najjarapu/PCB_Waveguides_for_Houck_Lab_of_Quantum_Computing/Cadence Allegro Files/Board Imports/netlist_8_SSMA_8_filter_12_screwhole.txt

(NETLIST)
(FOR DRAWING: /n/homeserver2/user2a/ajjarapu/quibit_qed_III_info/qubit_qed_III.brd)

(GENERATED BY: ALLEGRO 16.6 S006 (v16-6-112Z))

(Wed Jul  8 16:53:02 2015)

$PACKAGES
HOLE070P ! HOLE070P ; MTG1 MTG2 MTG3 MTG4 MTG5 MTG6 MTG7 MTG8 

SSMA_BB ! SSMA_BB ; J1 J2 J3 J4 J5 J6 J7 J8 J9 J10 J11 J12
 
FILTER ! FILTER ; R1 R2 R3 R4 R5 R6 R7 R8 R9 R10 R11 R12 
 $NETS
GND ; J1.2 J1.3 J2.2 J2.3 J3.2 J3.3 J4.2 J4.3 J5.2 J5.3 J6.2 J6.3 J7.2 J7.3,
J8.2 J8.3 J9.2 J9.3 J10.2 J10.3 J11.2 J11.3 J12.2 J12.3 MTG1.1 MTG2.1 MTG3.1,
MTG4.1 MTG5.1 MTG6.1 MTG7.1 MTG8.1
MICROWAVE ; J1.1 J2.1 J3.1 J4.1 J5.1 J6.1 J7.1 J8.1 J9.1 J10.1 J11.1 J12.1,
R1.1 R2.1 R3.1 R4.1 R5.1 R6.1 R7.1 R8.1 R9.1 R10.1 R11.1 R12.1 
$PINS
$A_PROPERTIES
DYN_THERMAL_CON_TYPE 'FULL_CONTACT'; MTG5.1 MTG6.1 MTG4.1 MTG1.1 MTG3.1,
MTG2.1 MTG7.1 MTG8.1
DYN_CLEARANCE_TYPE 'ANTI_THERMAL'; J3.1 J1.1 J5.1 J7.1 J9.1 J8.1 J11.1,
J12.1 J10.1 J4.1 J2.1 J6.1
$END
