najjarapu/PCB_Waveguides_for_Houck_Lab_of_Quantum_Computing/Cadence Allegro Files/Art/98_board_art/NOTES/More Notes.txt

- DRILLING: ALL HOLES TO BE LOCATED BY X & Y COORDINATES 
   FROM NC DRILL DATA SUPPLIED. SEE DRILL TABLE FOR HOLE 
   SIZES AND QUANTITY DRILLED HOLE TRUE POSITION DIFFERENCE 
   FROM CAD DATA IS NOT TO EXCESS 0.005"
 - MINIMUM ANULAR RING OF 1 MIL. UNLESS OTHERWISE SPECIFIED
 - COPPER PLATING HOLE WALL TO BE .001" MINIMUM 
 - FINISH COPPER SURFACE NOT TO BE PLATED
 - CONDUCTOR: WIDTHS AND SPACING: TRACE WIDTH CAN BE 
   MODIFIED TO ACHEIVE 50 OHM CHARACTERISITC IMPEDANCE 
 - CENTER CUTOUT SQUARE CENTERED @ 0,0. CUTOUT 1-3 SHOULD
   EXPOSE LAYER 03_SIG COPPER TRACE
