najjarapu/PCB_Waveguides_for_Houck_Lab_of_Quantum_Computing/Cadence Allegro Files/Art/98_board_art/NOTES/More Notes - Copy.txt

 - CENTER CUTOUT SQUARE CENTERED @ 0,0. CUTOUT 1-3 SHOULD
   EXPOSE LAYER 03_SIG COPPER TRACE
