najjarapu/PCB_Waveguides_for_Houck_Lab_of_Quantum_Computing/Cadence Allegro Files/allegro_project/worklib/test070615/physical/139cad.dxf

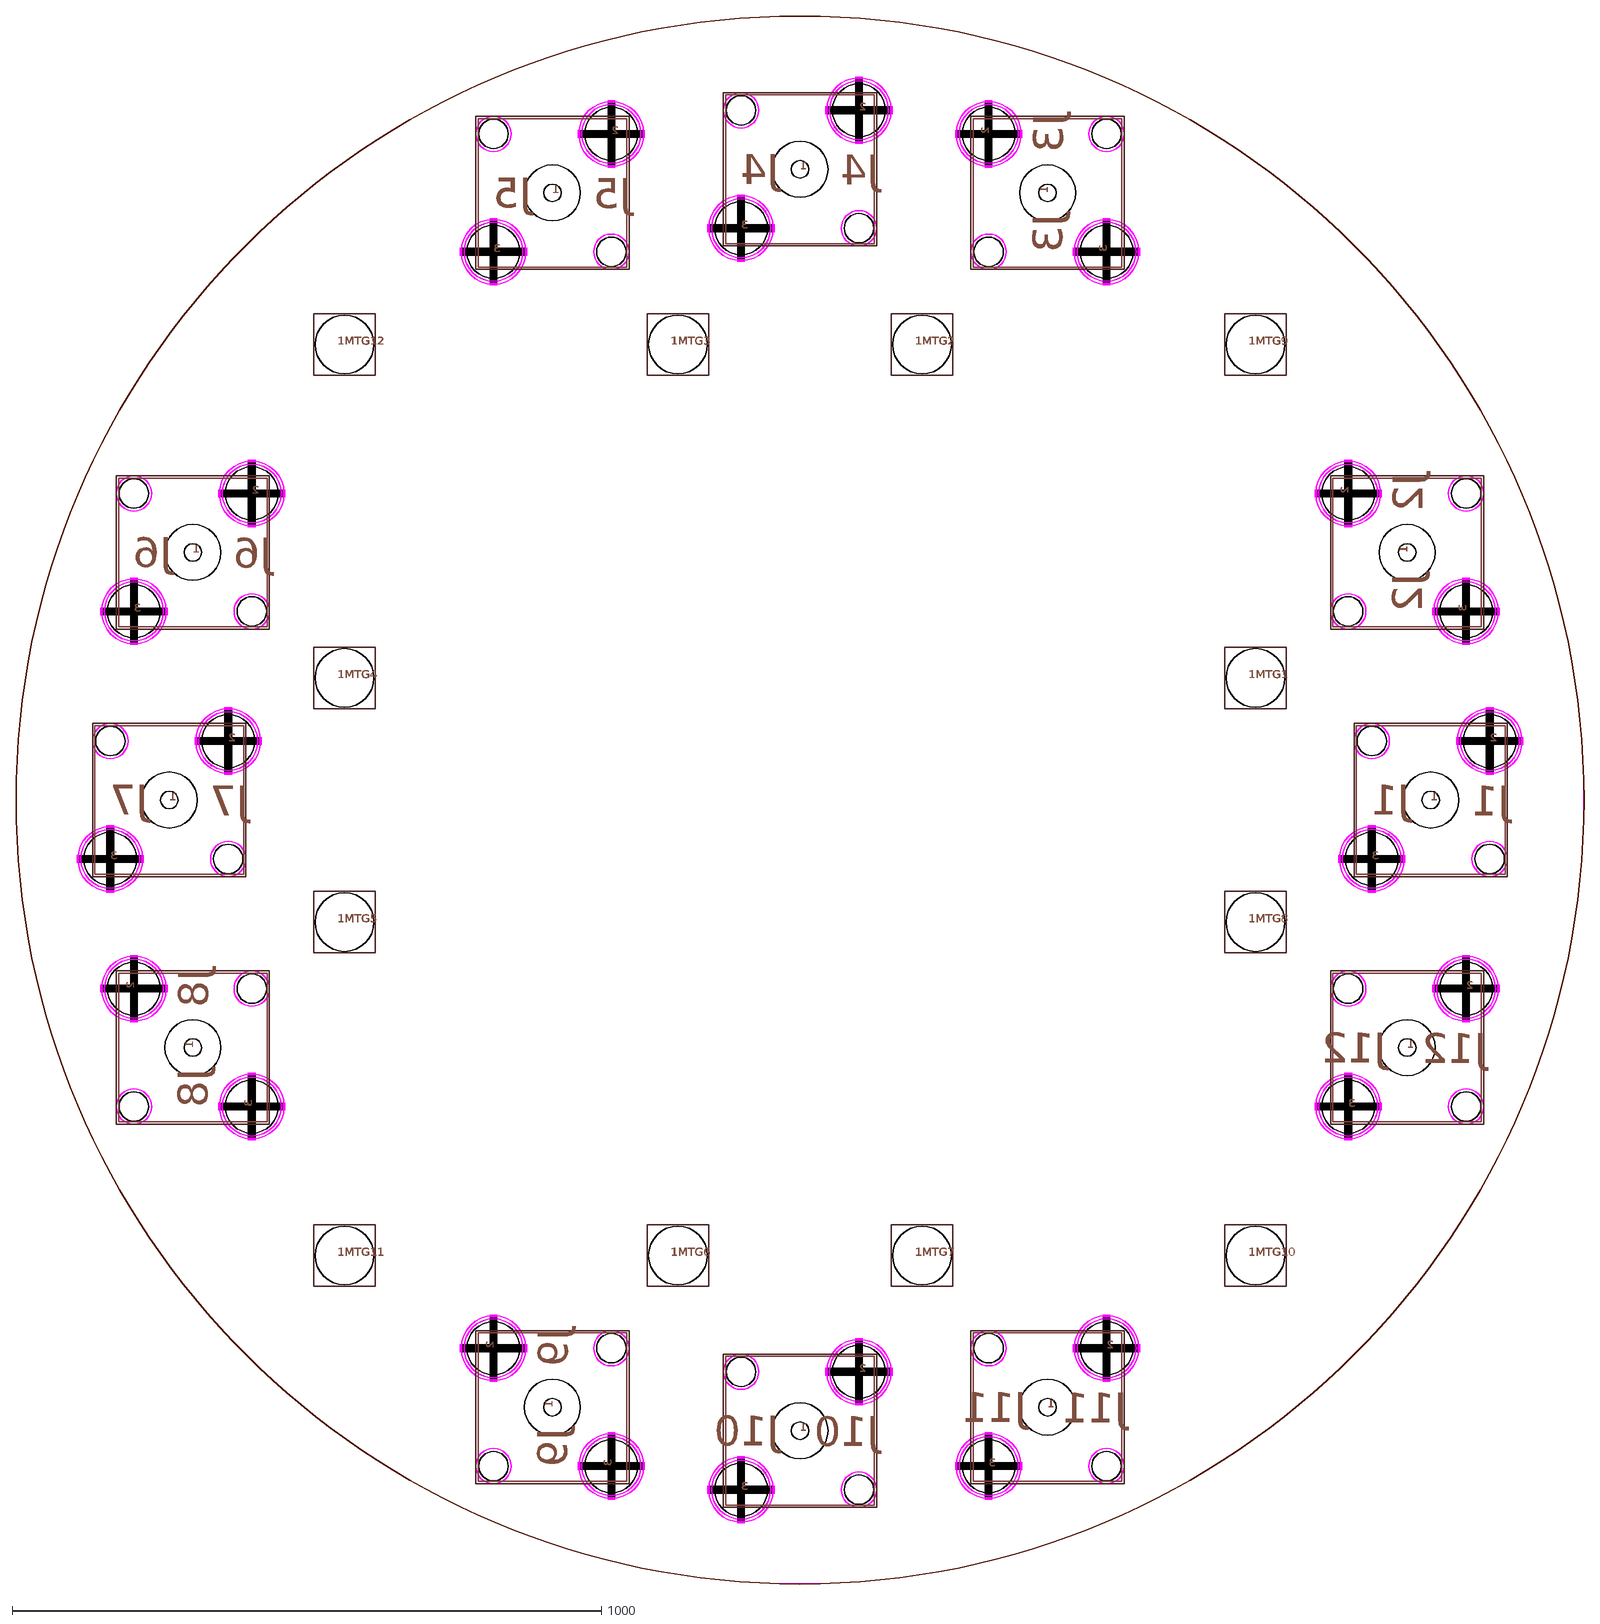
[picture p1: CAD file, 2015-08-13]
Cadence Allegro Files/allegro_project/worklib/test070615/physical/139cad.dxf
1
MTG12
MTG11
MTG10
MTG9
MTG8
MTG7
MTG6
MTG5
MTG4
MTG3
MTG2
MTG1
2
3
J12
J11
J10
J9
J8
J7
J6
J5
J4
J3
J2
J1
