najjarapu/PCB_Waveguides_for_Houck_Lab_of_Quantum_Computing/Cadence Allegro Files/Copper Cad Files/PCB_Bottom_7X7/PCB_bottom_7X7.dxf

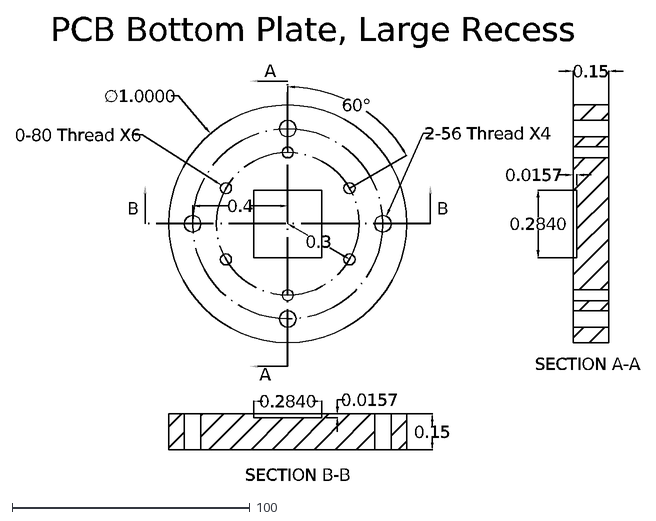
[picture p2: CAD file, 2015-08-13]
Cadence Allegro Files/Copper Cad Files/PCB_Bottom_7X7/PCB_bottom_7X7.dxf
∅1.0000
0-80 Thread X6
2-56 Thread X4
A
B
0.15
SECTION A-A
SECTION B-B
60°
0.3
0.4
0.0157
0.2840
PCB Bottom Plate, Large Recess
