najjarapu/PCB_Waveguides_for_Houck_Lab_of_Quantum_Computing/Cadence Allegro Files/Copper Cad Files/PCB_Top_7X7/PCB_top.dxf

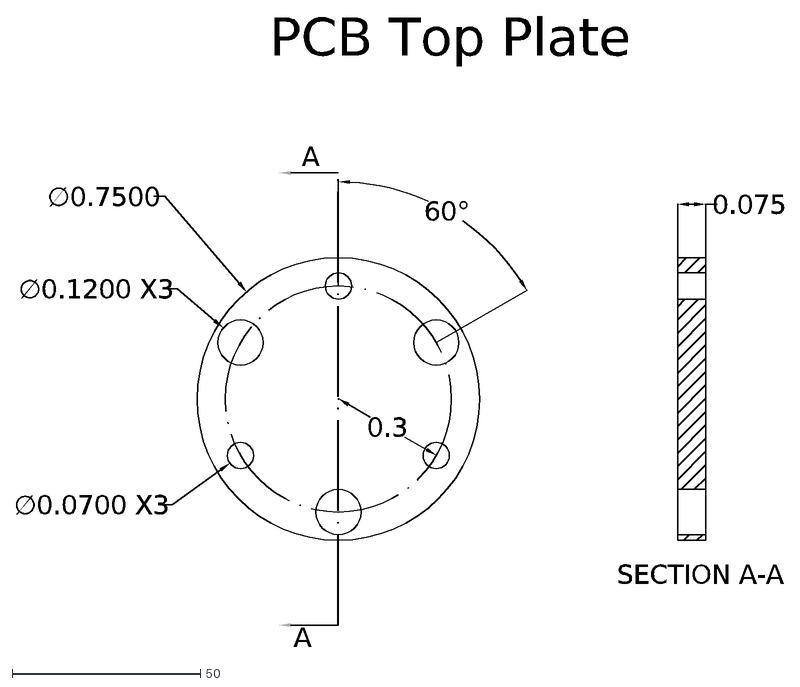
[picture p3: CAD file, 2015-08-13]
Cadence Allegro Files/Copper Cad Files/PCB_Top_7X7/PCB_top.dxf
∅0.7500
A
0.075
SECTION A-A
60°
∅0.1200 X3
∅0.0700 X3
0.3
PCB Top Plate
