najjarapu/PCB_Waveguides_for_Houck_Lab_of_Quantum_Computing/Cadence Allegro Files/Copper Cad Files/Rod/rod_90.dxf

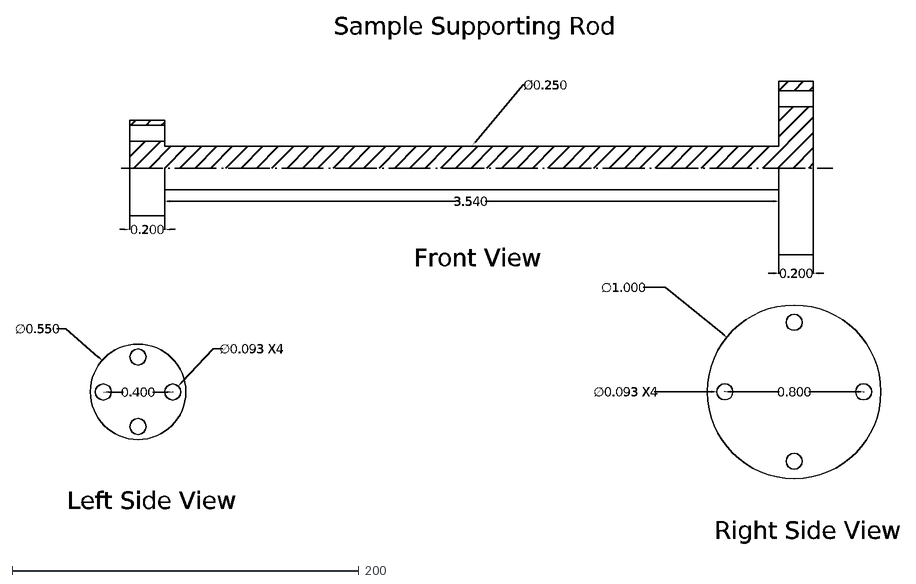
[picture p4: CAD file, 2015-08-13]
Cadence Allegro Files/Copper Cad Files/Rod/rod_90.dxf
Sample Supporting Rod
Ø0.250
Front View
∅0.550
Left Side View
0.200
Right Side View
∅1.000
∅0.093 X4
0.400
0.800
3.540
