najjarapu/PCB_Waveguides_for_Houck_Lab_of_Quantum_Computing/(list of files, cad)

Other CAD files:
Cadence Allegro Files/Copper Cad Files/FilterCopperBottom/FIlterCopperBottom.dwg
Cadence Allegro Files/Copper Cad Files/FilterCopperTop/FilterCopperTop.dwg
Cadence Allegro Files/Copper Cad Files/PCB_BOTTOM_139/PCB_BOTTOM_RECT.dwg
Cadence Allegro Files/Copper Cad Files/PCB_BOttom_98/PCB_BOTTOM_98.dwg
Cadence Allegro Files/Copper Cad Files/PCB_TOP_98_139/PCB_TOP_RECT.dwg
Cadence Allegro Files/Boards/OlderBoards/Spiral_DuoDeca.dwg
Cadence Allegro Files/Copper Cad Files/PCB_Bottom_7X7/PCB_bottom_7X7.dwg
Cadence Allegro Files/Copper Cad Files/PCB_Top_7X7/PCB_top.dwg
Cadence Allegro Files/Copper Cad Files/Rod/rod_90.dwg
Cadence Allegro Files/allegro_project/worklib/test070615/physical/7_7_slot_sym.psm
Cadence Allegro Files/allegro_project/worklib/test070615/physical/filter.psm
Cadence Allegro Files/allegro_project/worklib/test070615/physical/hole070p.psm
Cadence Allegro Files/allegro_project/worklib/test070615/physical/ssma_bb.psm
Cadence Allegro Files/allegro_project/worklib/test070615/physical/via10sym.psm
