najjarapu/PCB_Waveguides_for_Houck_Lab_of_Quantum_Computing/Cadence Allegro Files/Art/98_board_art/NOTES/MANUFACTURE_NOTES.txt

NOTES: UNLESS OTHERWISE SPECIFIED
 - CLASS 2
 - MATERIAL: FR408 RECOMMENDED
 - COPPER WEGITH: SEE XSECTION
 - BOARD FINISH THICKNESS; 0.057 INCHES +/- <.010 OR 10%
 - SOLDERMASK: NOT REQUIRED
 - ALL INSIDE CORNERS AND SLOTS SHALL HAVE .062 INCHES 
   +/- 0.005" OR LESS RADIUS
 - LEGEND/SILKSCREEN: NOT REQUIRED
