najjarapu/PCB_Waveguides_for_Houck_Lab_of_Quantum_Computing/Cadence Allegro Files/allegro_project/worklib/test070615/physical/netlist_only adds_MTG_7_8.txt

(NETLIST)
(FOR DRAWING: /n/homeserver2/user2a/ajjarapu/quibit_qed_III_info/qubit_qed_III.brd)

(GENERATED BY: ALLEGRO 16.6 S006 (v16-6-112Z))

(Wed Jul  8 16:53:02 2015)

$PACKAGES
HOLE070P ! HOLE070P ; MTG7 MTG8

 $NETS
GND ; MTG7.1 MTG8.1 
$PINS
$A_PROPERTIES
DYN_THERMAL_CON_TYPE 'FULL_CONTACT'; MTG7.1 MTG8.1
 $END
