najjarapu/PCB_Waveguides_for_Houck_Lab_of_Quantum_Computing/Cadence Allegro Files/allegro_project/worklib/test070615/physical/Art/FILTERBOARD_PARTIAL_ART/FILTERBOARDPARTIAL.pdf

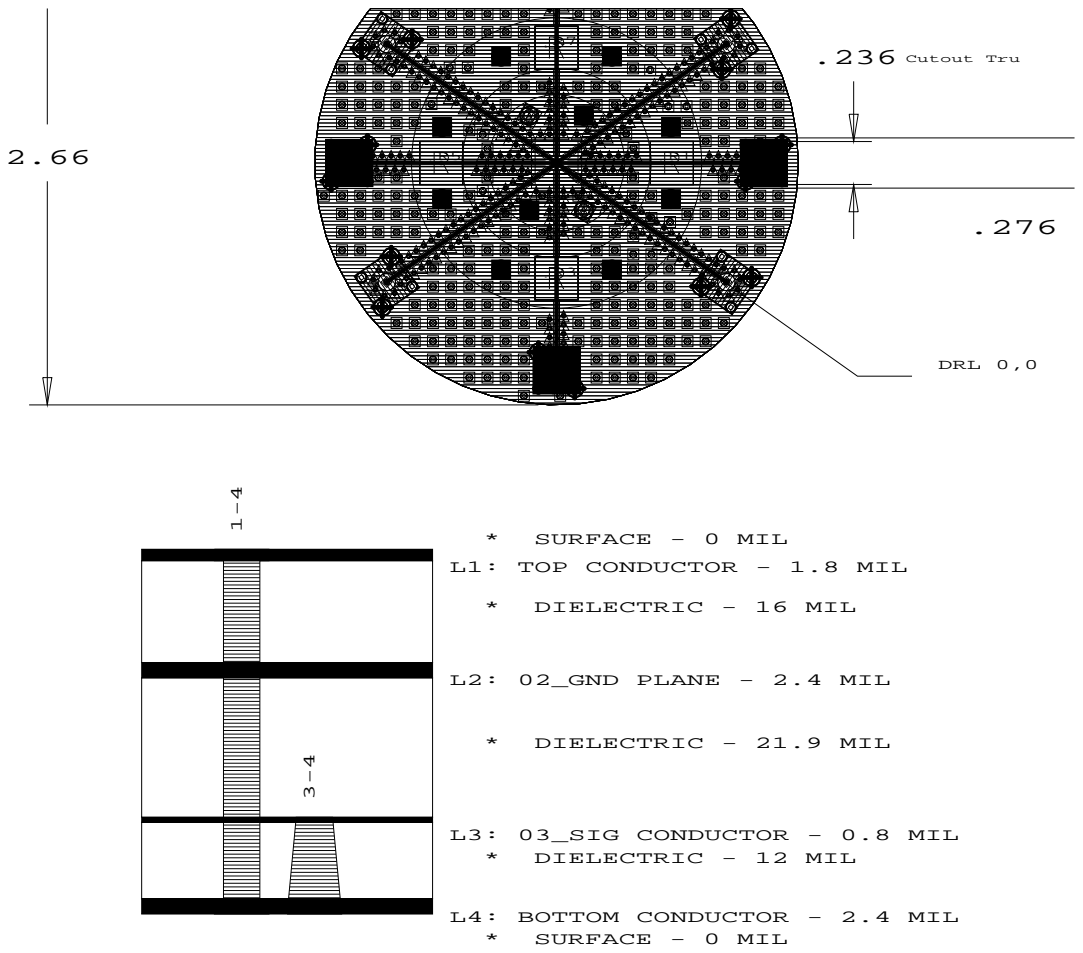
[picture p5: page 1]

1 MTG7 | 1 MTG2

1 MTG6 | R3 | 1 MTG3

# .276 Cutout 1-3

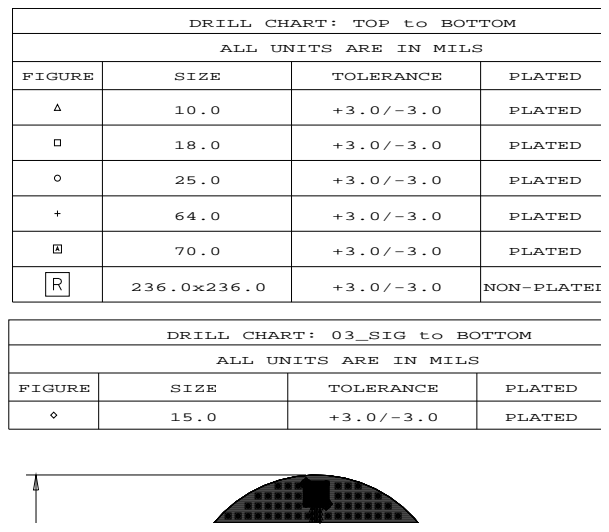
[picture p6: page 3]

DRILL CHART: TOP to BOTTOM
ALL UNITS ARE IN MILS

FIGURE | SIZE | TOLERANCE | PLATED

10.0 | +3.0/-3.0 | PLATED

18.0 | +3.0/-3.0 | PLATED

25.0 | +3.0/-3.0 | PLATED

64.0 | +3.0/-3.0 | PLATED

70.0 | +3.0/-3.0 | PLATED

DRILL CHART: 03_SIG to BOTTOM

15.0 | +3.0/-3.0 | PLATED

NOTES: UNLESS OTHERWISE SPECIFIED
- CLASS 2
- MATERIAL: FR408 RECOMMENDED
- COPPER WEGITH: SEE XSECTION
- BOARD FINISH THICKNESS; 0.057 INCHES +/- <.010 OR 10%
- SOLDERMASK: NOT REQUIRED
- ALL INSIDE CORNERS AND SLOTS SHALL HAVE .062 INCHES +/- 0.005" OR LESS RADIUS
- LEGEND/SILKSCREEN: NOT REQUIRED
- DRILLING: ALL HOLES TO BE LOCATED BY X & Y COORDINATES FROM NC DRILL DATA SUPPLIED. SEE DRILL TABLE FOR HOLE SIZES AND QUANTITY DRILLED HOLE TRUE POSITION DIFFERENCE FROM CAD DATA IS NOT TO EXCESS 0.005"
- MINIMUM ANULAR RING OF 1 MIL. UNLESS OTHERWISE SPECIFIED
- COPPER PLATING HOLE WALL TO BE .001" MINIMUM
- FINISH COPPER SURFACE NOT TO BE PLATED
- CONDUCTOR: WIDTHS AND SPACING: TRACE WIDTH CAN BE MODIFIED TO ACHEIVE 50 OHM CHARACTERISITC IMPEDANCE
- ON THE 8 CAVITIES (R), PLEASE CREATE A 7 MIL X 7 MIL ABOVE THEM IN THE SAME ORIENTATION THROUGH LAYERS 1 AND
2 TO EXPOSE LAYER 3 (SAME DIMENSIONS AS CENTER CAVITY)
4 | 7MM x 7MM

# QTY

286

299

16

16

12

# NON-PLATED 4

8

# QTY
