najjarapu/PCB_Waveguides_for_Houck_Lab_of_Quantum_Computing/Cadence Allegro Files/Copper Cad Files/PCB_Bottom_7X7/PCB_bottom_7X7.pdf

# PCB Bottom Plate, Large Recess

### PRODUCED BY AN AUTODESK EDUCATIONAL PRODUCT

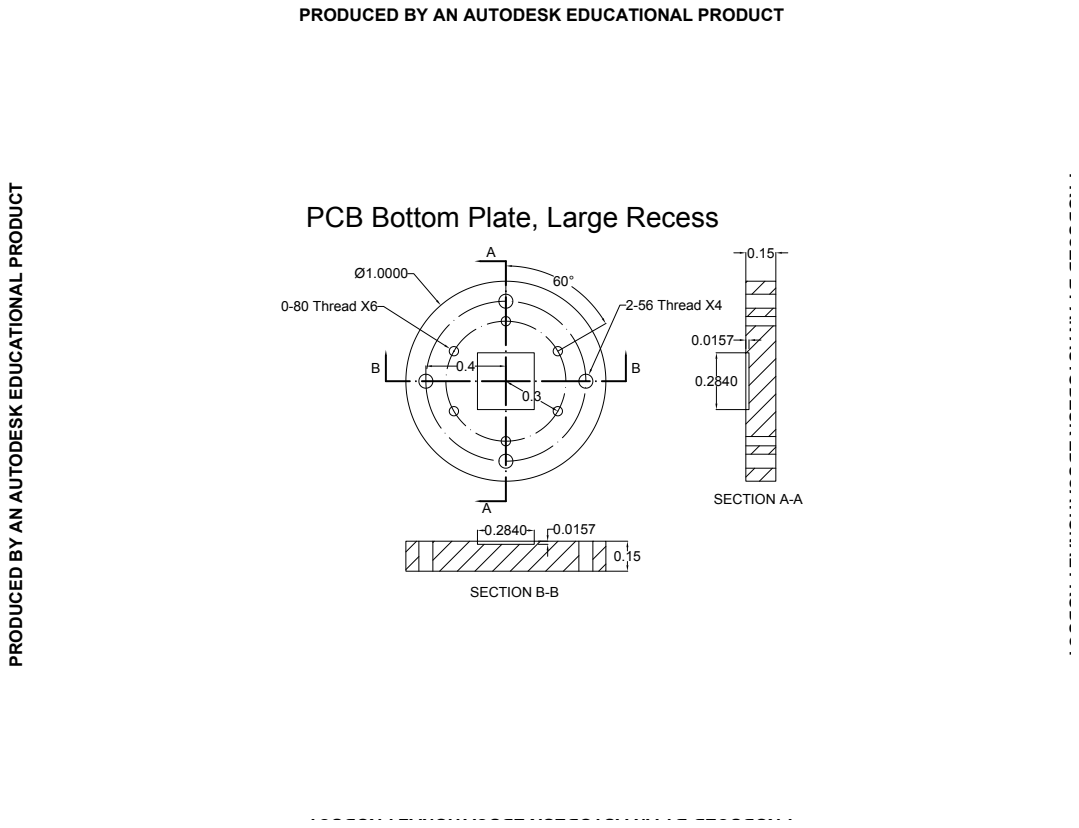
[picture p7: page 1]
0-80 Thread X6; 2-56 Thread X4 AA B; SECTION A-A; SECTION B-B

PRODUCED BY AN AUTODESK EDUCATIONAL PRODUCT
