najjarapu/PCB_Waveguides_for_Houck_Lab_of_Quantum_Computing/Cadence Allegro Files/Copper Cad Files/PCB_Top_7X7/PCB_top.pdf

### PRODUCED BY AN AUTODESK EDUCATIONAL PRODUCT

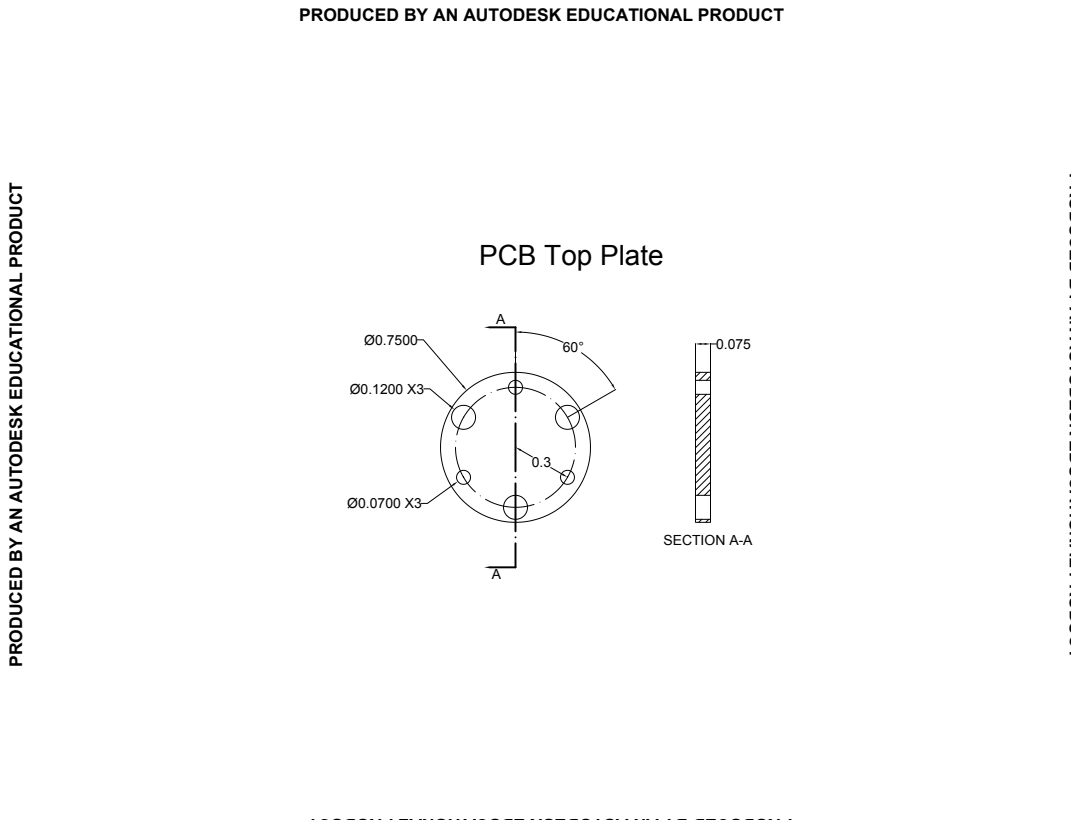
[picture p8: page 1]
SECTION A-A

PRODUCED BY AN AUTODESK EDUCATIONAL PRODUCT

PCB Top Plate
