najjarapu/PCB_Waveguides_for_Houck_Lab_of_Quantum_Computing/Cadence Allegro Files/Copper Cad Files/Rod/rod_90.pdf

# Sample Supporting Rod

### PRODUCED BY AN AUTODESK EDUCATIONAL PRODUCT

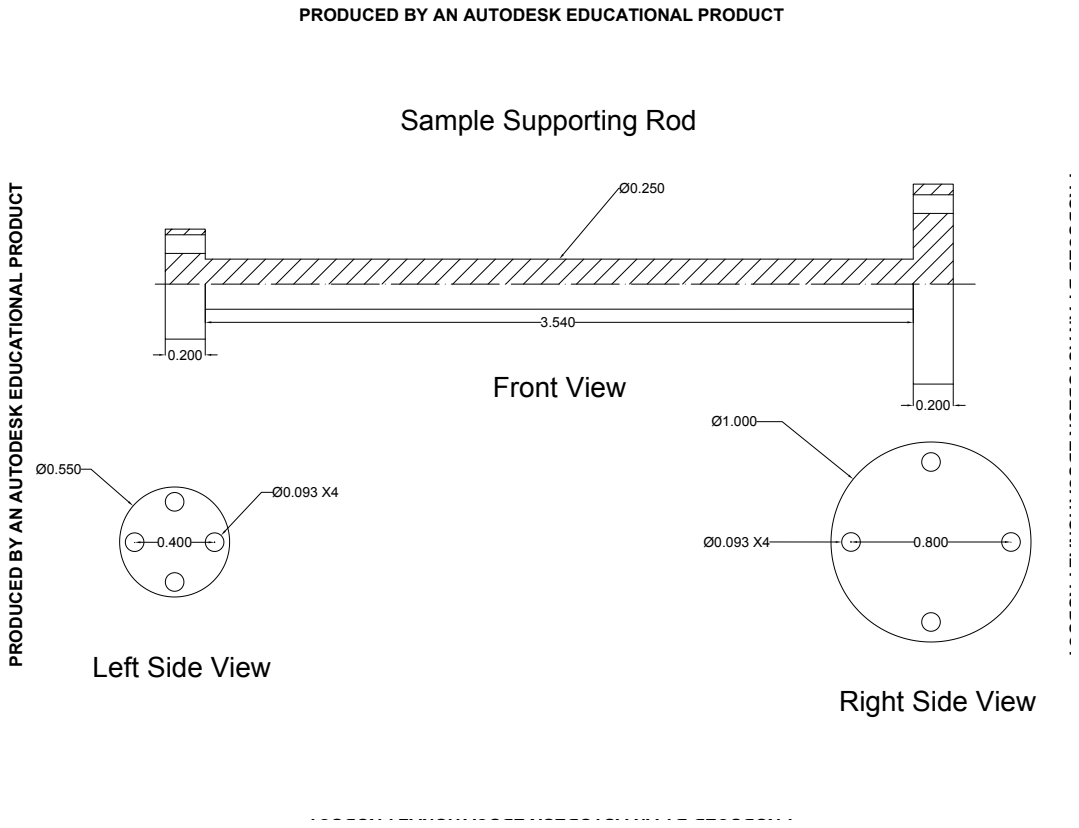
[picture p9: page 1]
Front View

PRODUCED BY AN AUTODESK EDUCATIONAL PRODUCT

Left Side View

Right Side View
