najjarapu/PCB_Waveguides_for_Houck_Lab_of_Quantum_Computing/Cadence Allegro Files/Copper Cad Files/FilterCopperBottom/FIlterCopperBottomPrint.pdf

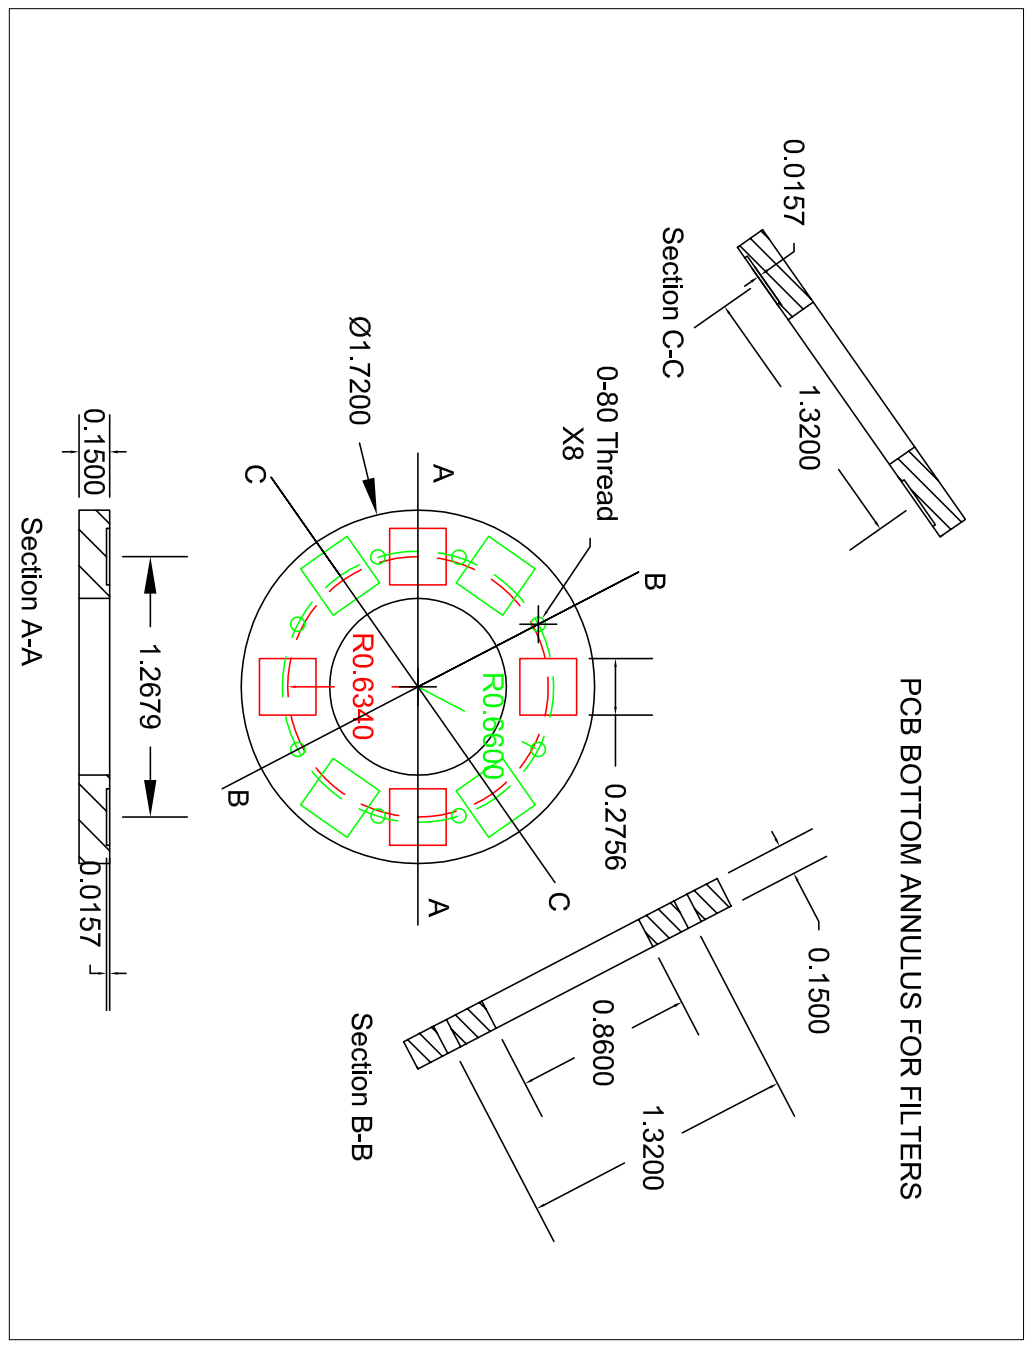
[picture p10: page 1]
