najjarapu/PCB_Waveguides_for_Houck_Lab_of_Quantum_Computing/Cadence Allegro Files/Copper Cad Files/FilterCopperTop/FilterCopperTopPrint.pdf

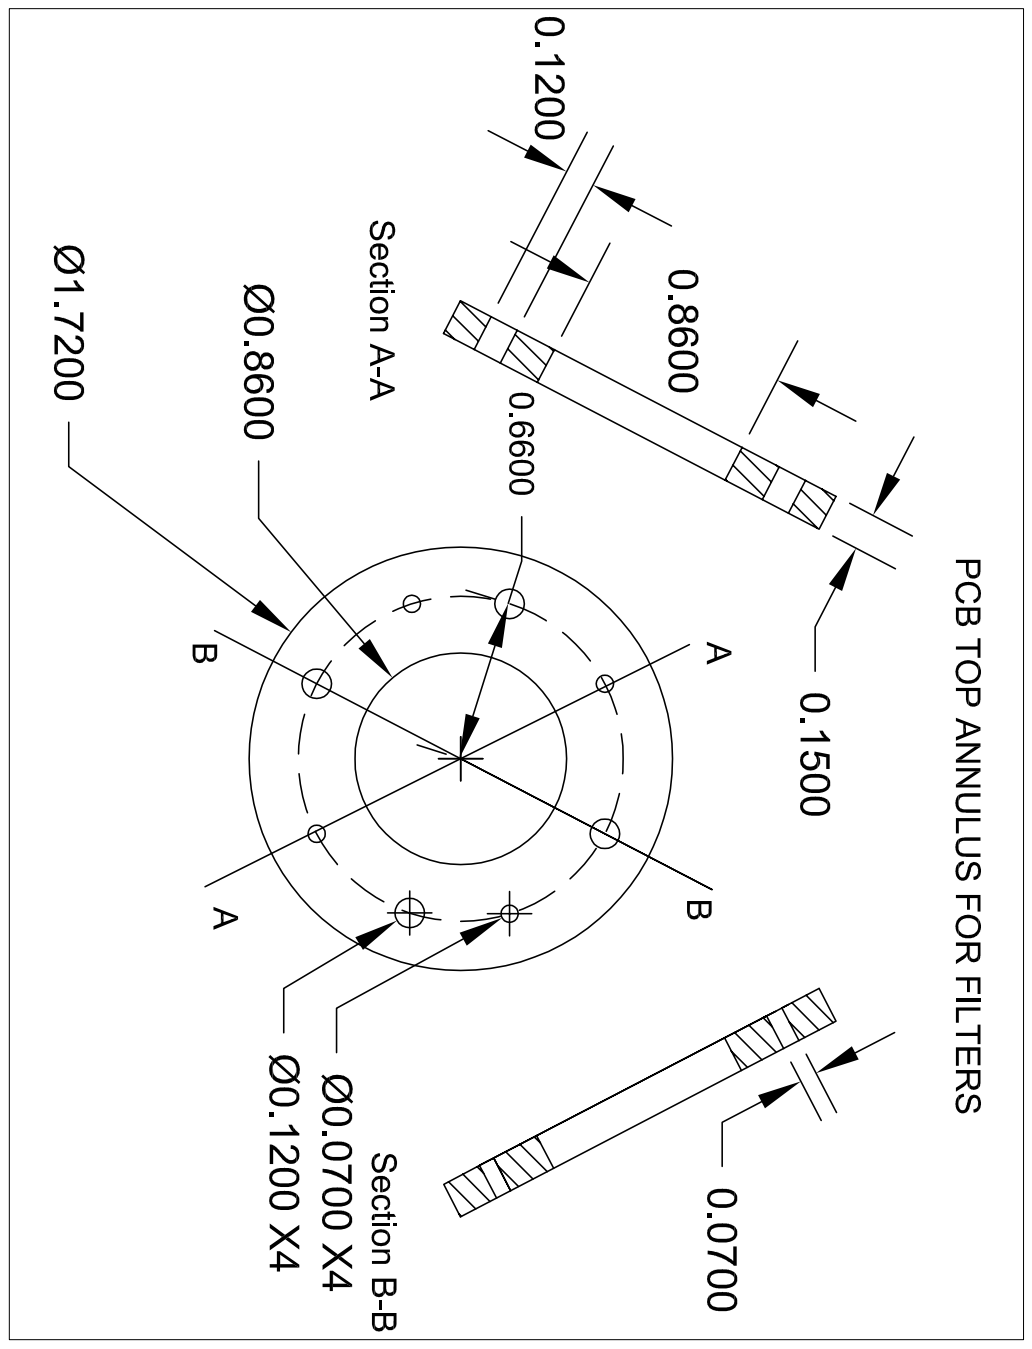
[picture p11: page 1]
