najjarapu/PCB_Waveguides_for_Houck_Lab_of_Quantum_Computing/Cadence Allegro Files/allegro_project/worklib/test070615/physical/FilterboardPartial_Art/filterboardpartialfabart.pdf

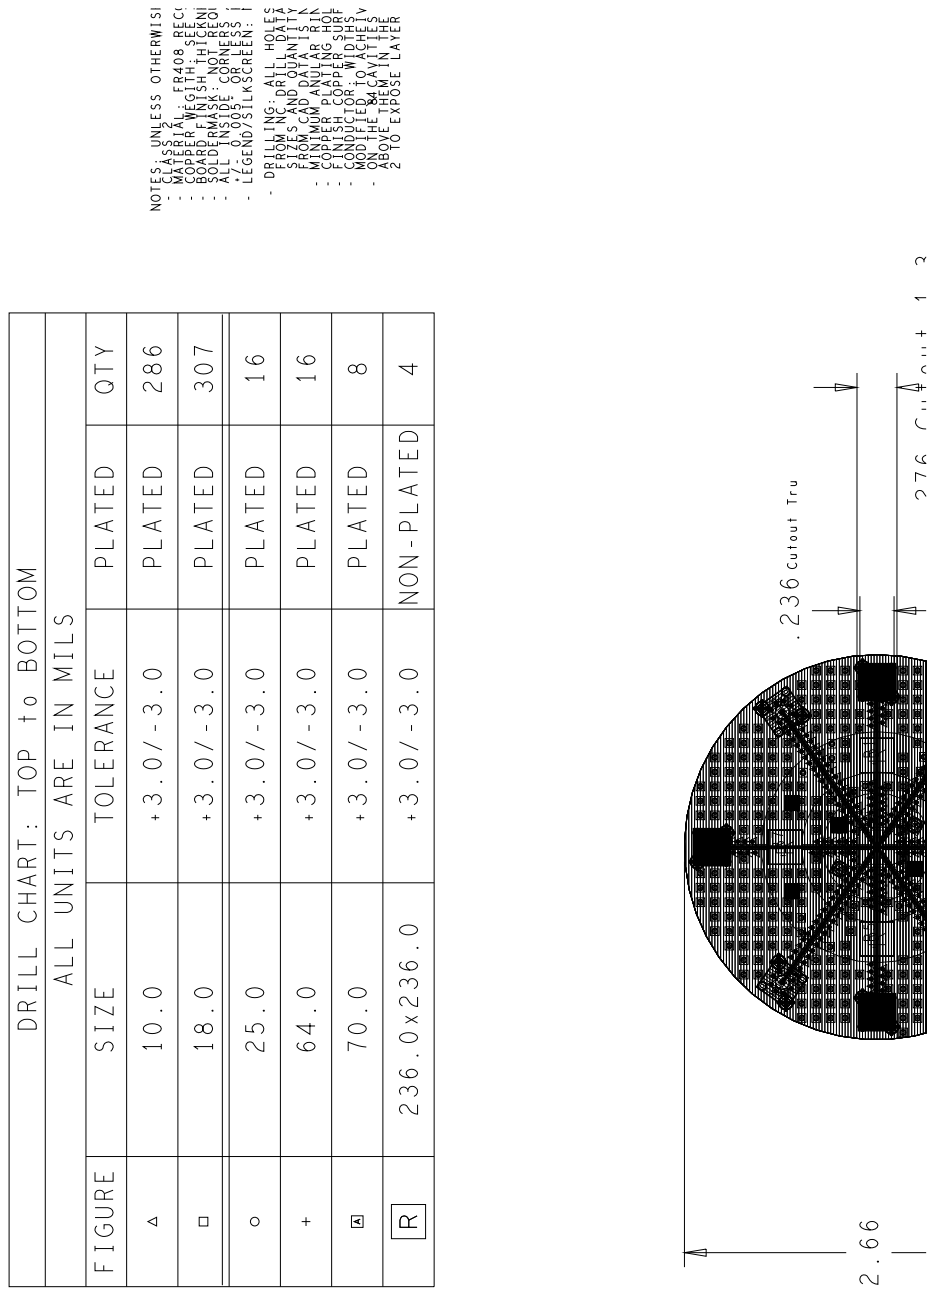
[picture p13: page 1]
