najjarapu/PCB_Waveguides_for_Houck_Lab_of_Quantum_Computing/Cadence Allegro Files/allegro_project/worklib/test070615/physical/Art/10x10_Art/10x10FabArt.pdf

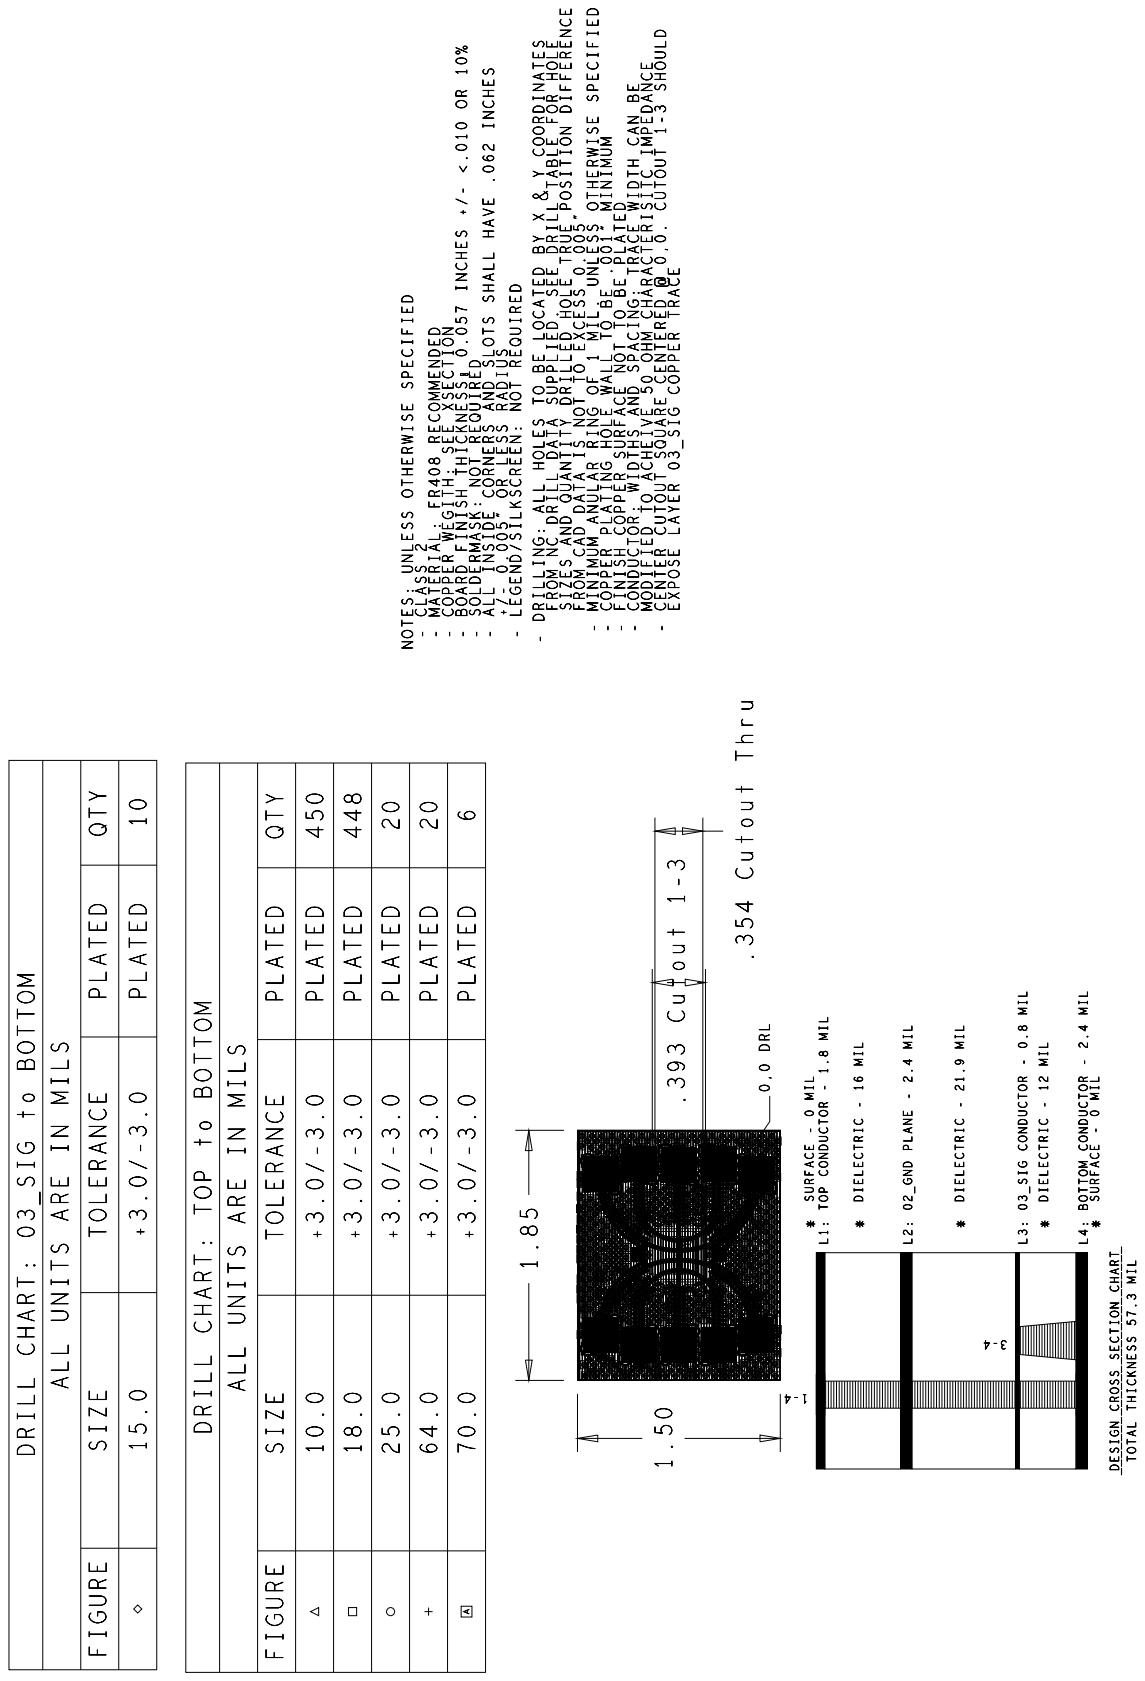
[picture p14: page 1]
