najjarapu/PCB_Waveguides_for_Houck_Lab_of_Quantum_Computing/Cadence Allegro Files/allegro_project/worklib/test070615/physical/Art/139_board_art/139FabArt.pdf

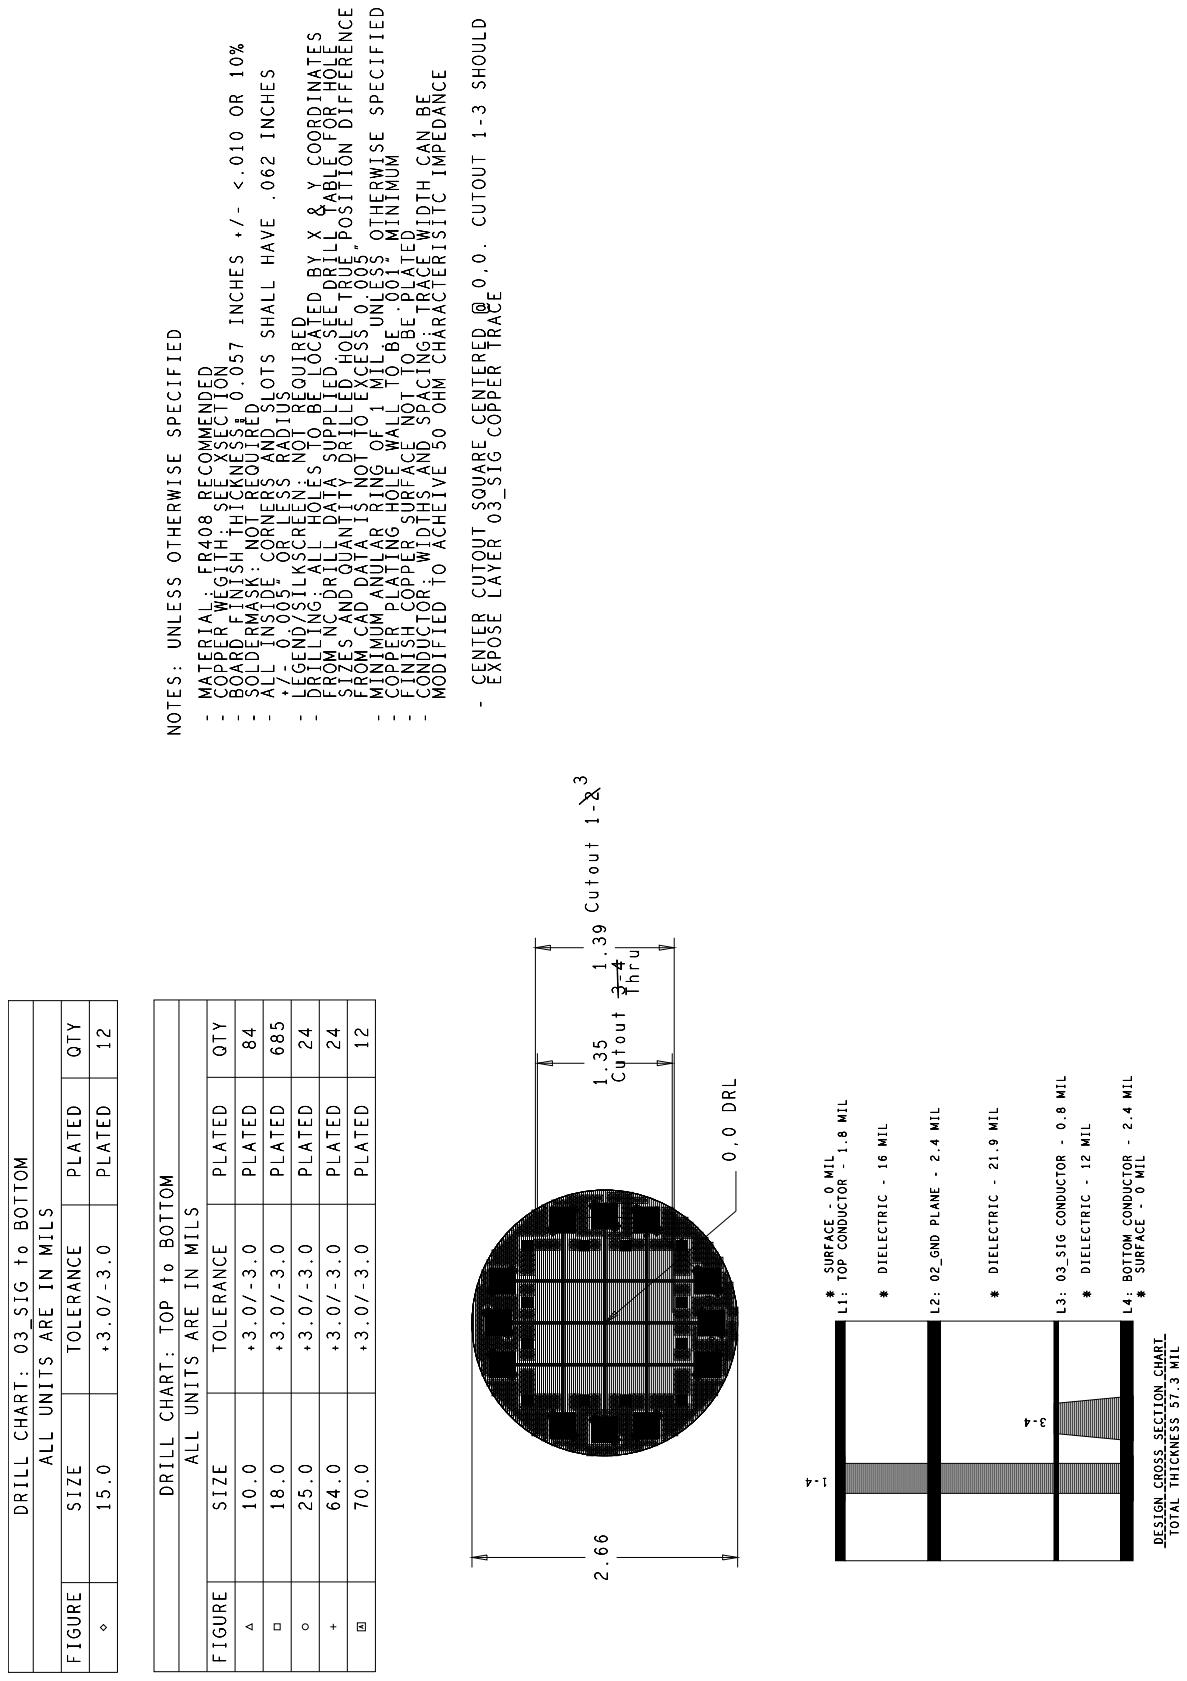
[picture p15: page 1]
