najjarapu/PCB_Waveguides_for_Houck_Lab_of_Quantum_Computing/Cadence Allegro Files/allegro_project/worklib/test070615/physical/Art/7X2_Art/7x2FabArt.pdf

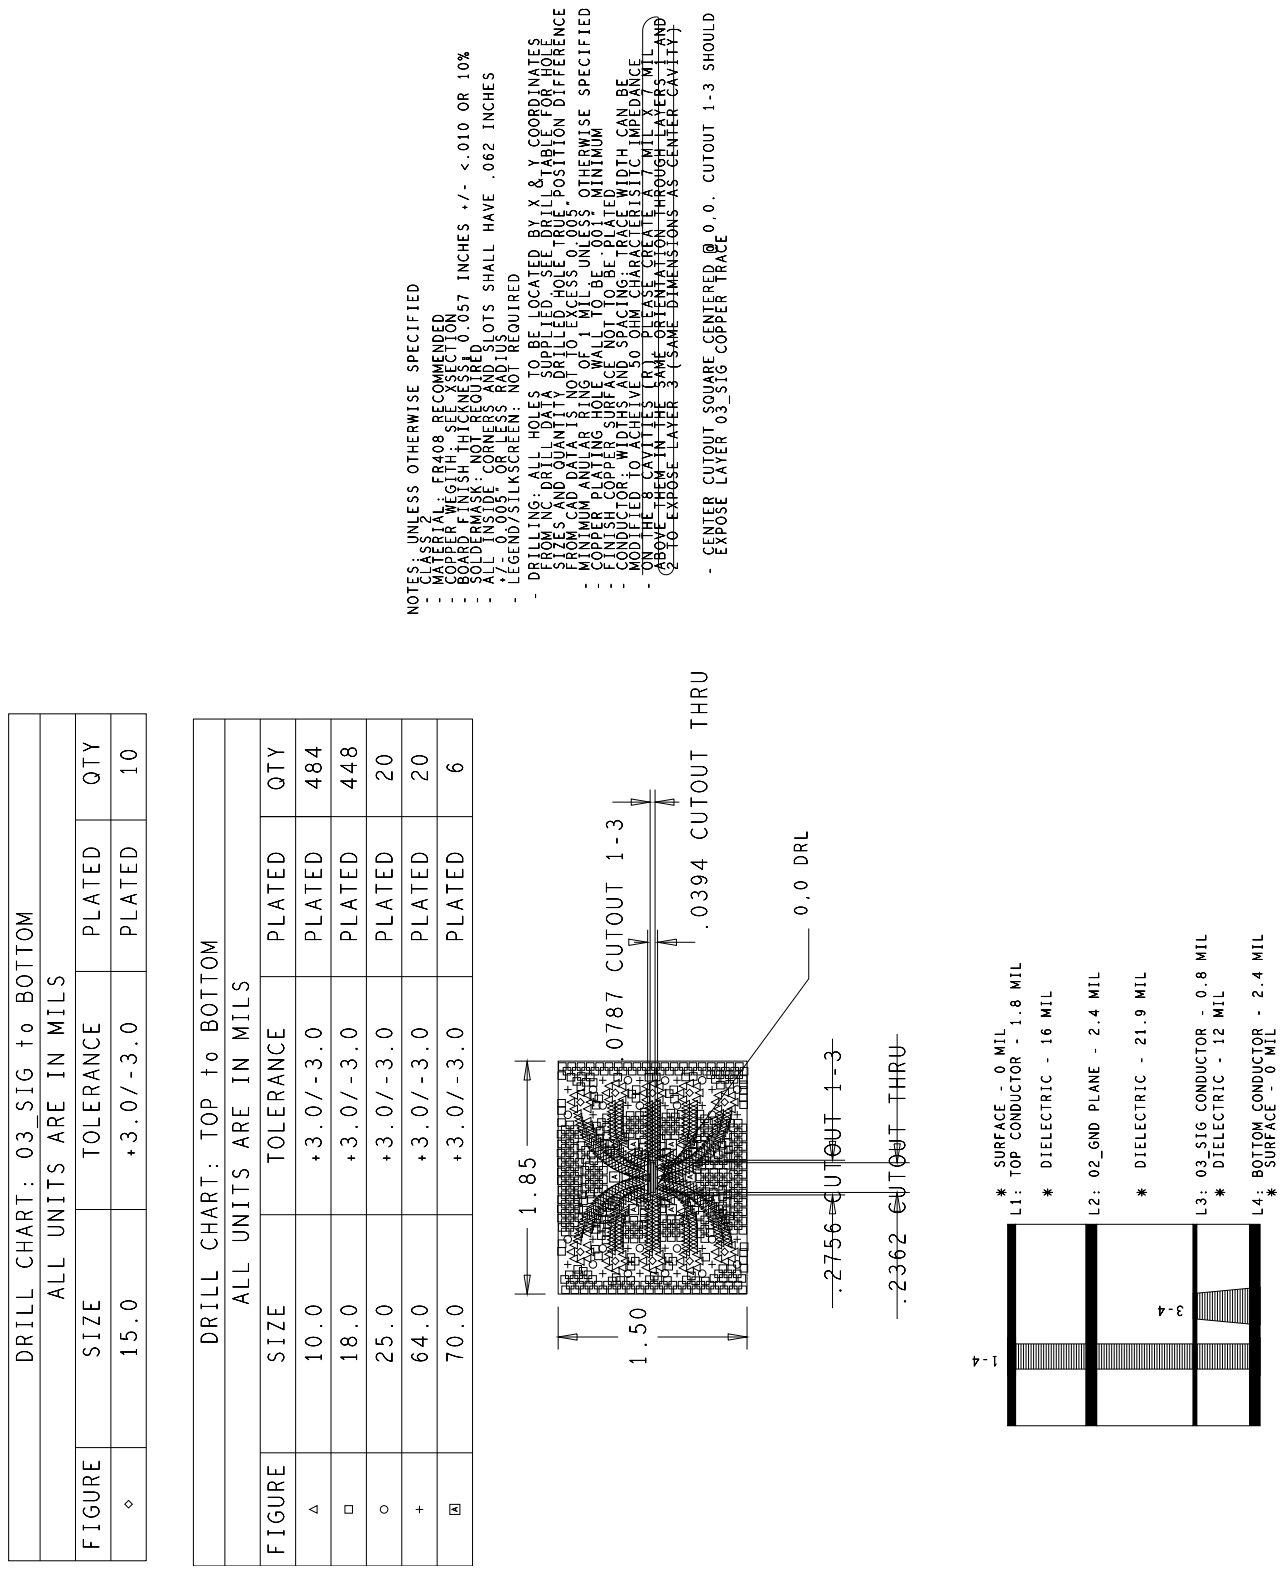
[picture p16: page 1]
