najjarapu/PCB_Waveguides_for_Houck_Lab_of_Quantum_Computing/Cadence Allegro Files/allegro_project/worklib/test070615/physical/Art/7x7_Art/7x7FabArt.pdf

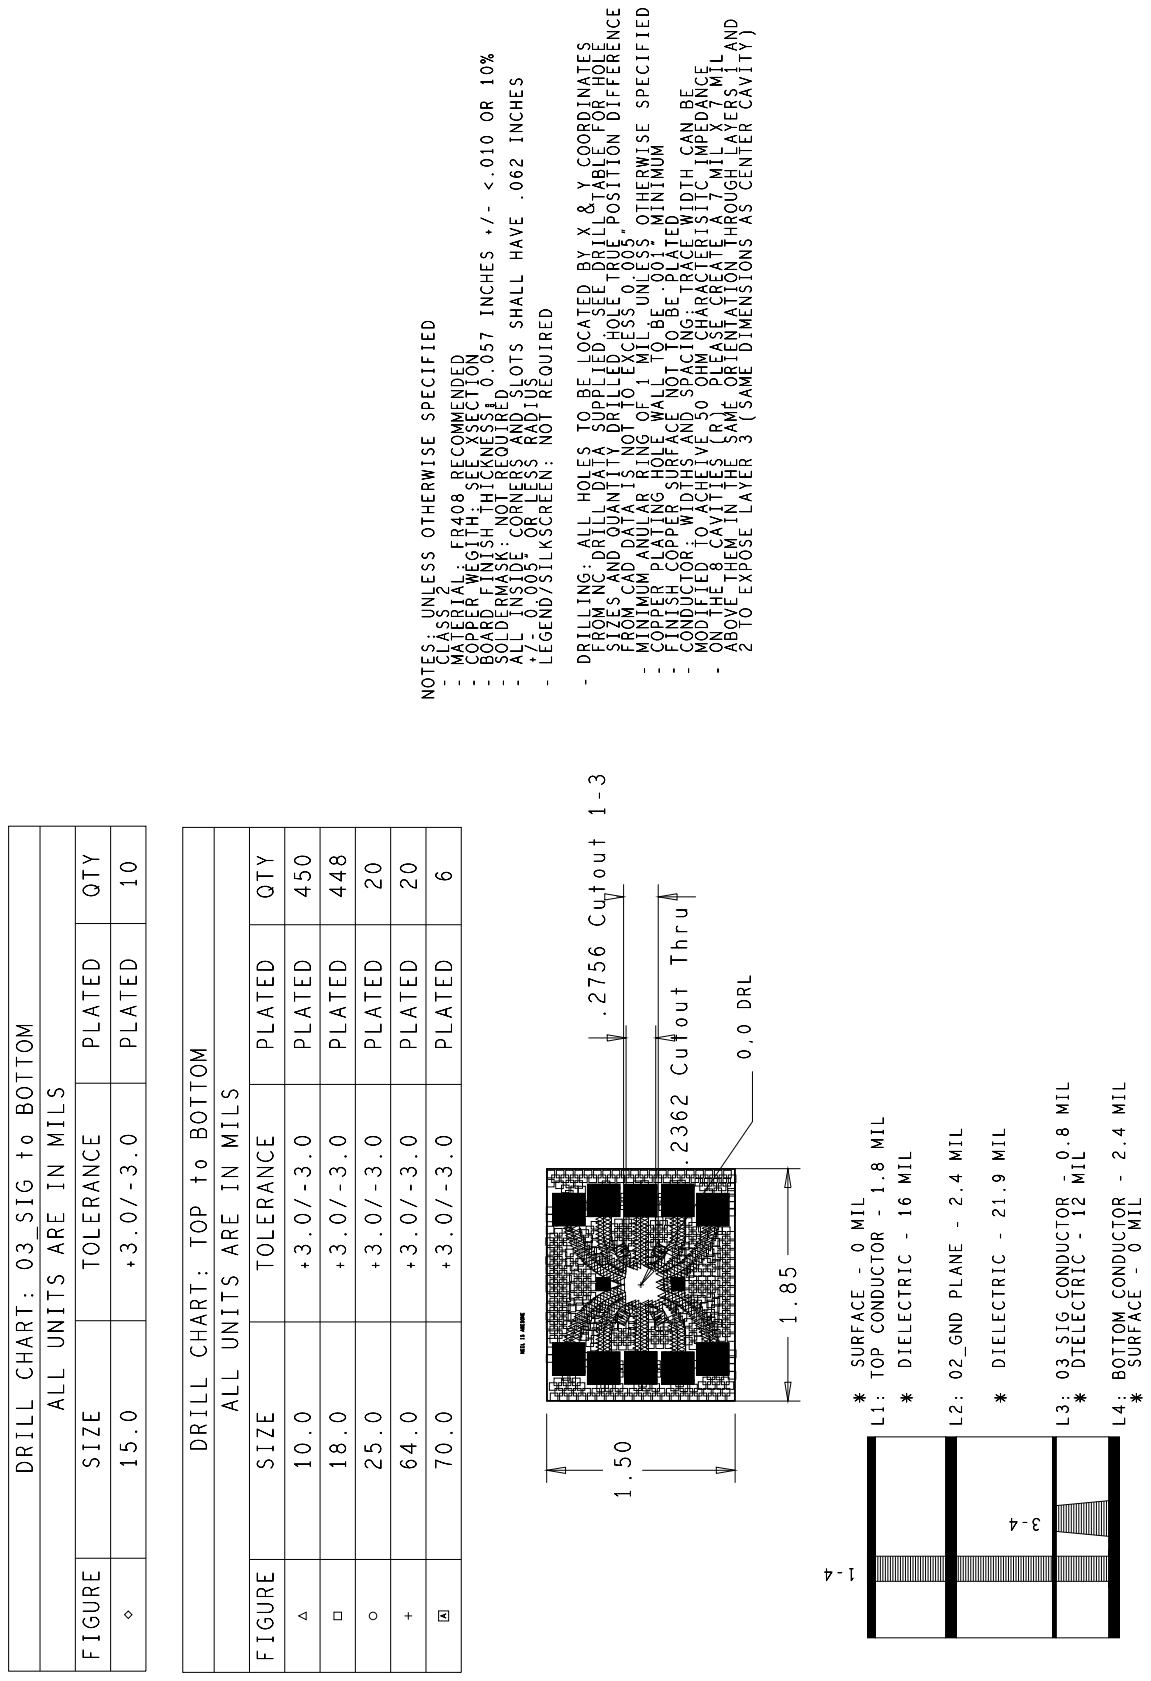
[picture p17: page 1]
