najjarapu/PCB_Waveguides_for_Houck_Lab_of_Quantum_Computing/Cadence Allegro Files/allegro_project/worklib/test070615/physical/Art/FILTERBOARD_ART/FILTERBOARDFABART.pdf

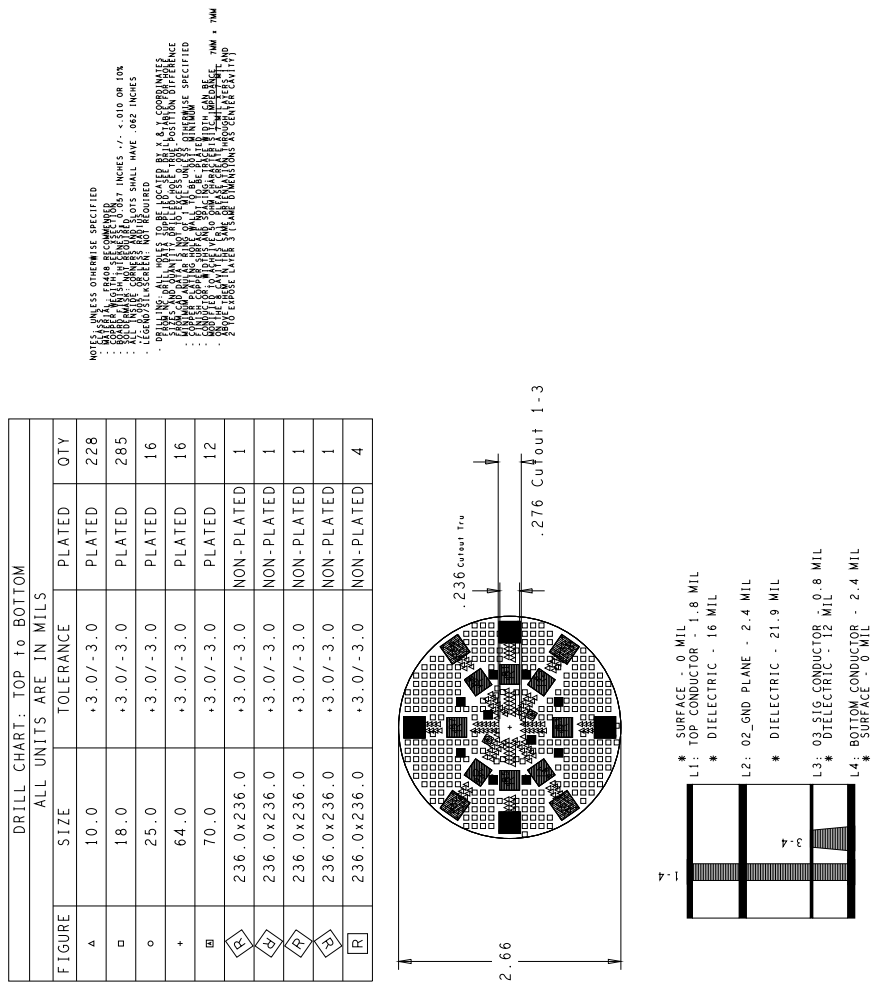
[picture p18: page 1]
