najjarapu/PCB_Waveguides_for_Houck_Lab_of_Quantum_Computing/Cadence Allegro Files/allegro_project/worklib/test070615/physical/oldart/Partial_FilterBoard_Art/PartialFilterBoardNotes.pdf

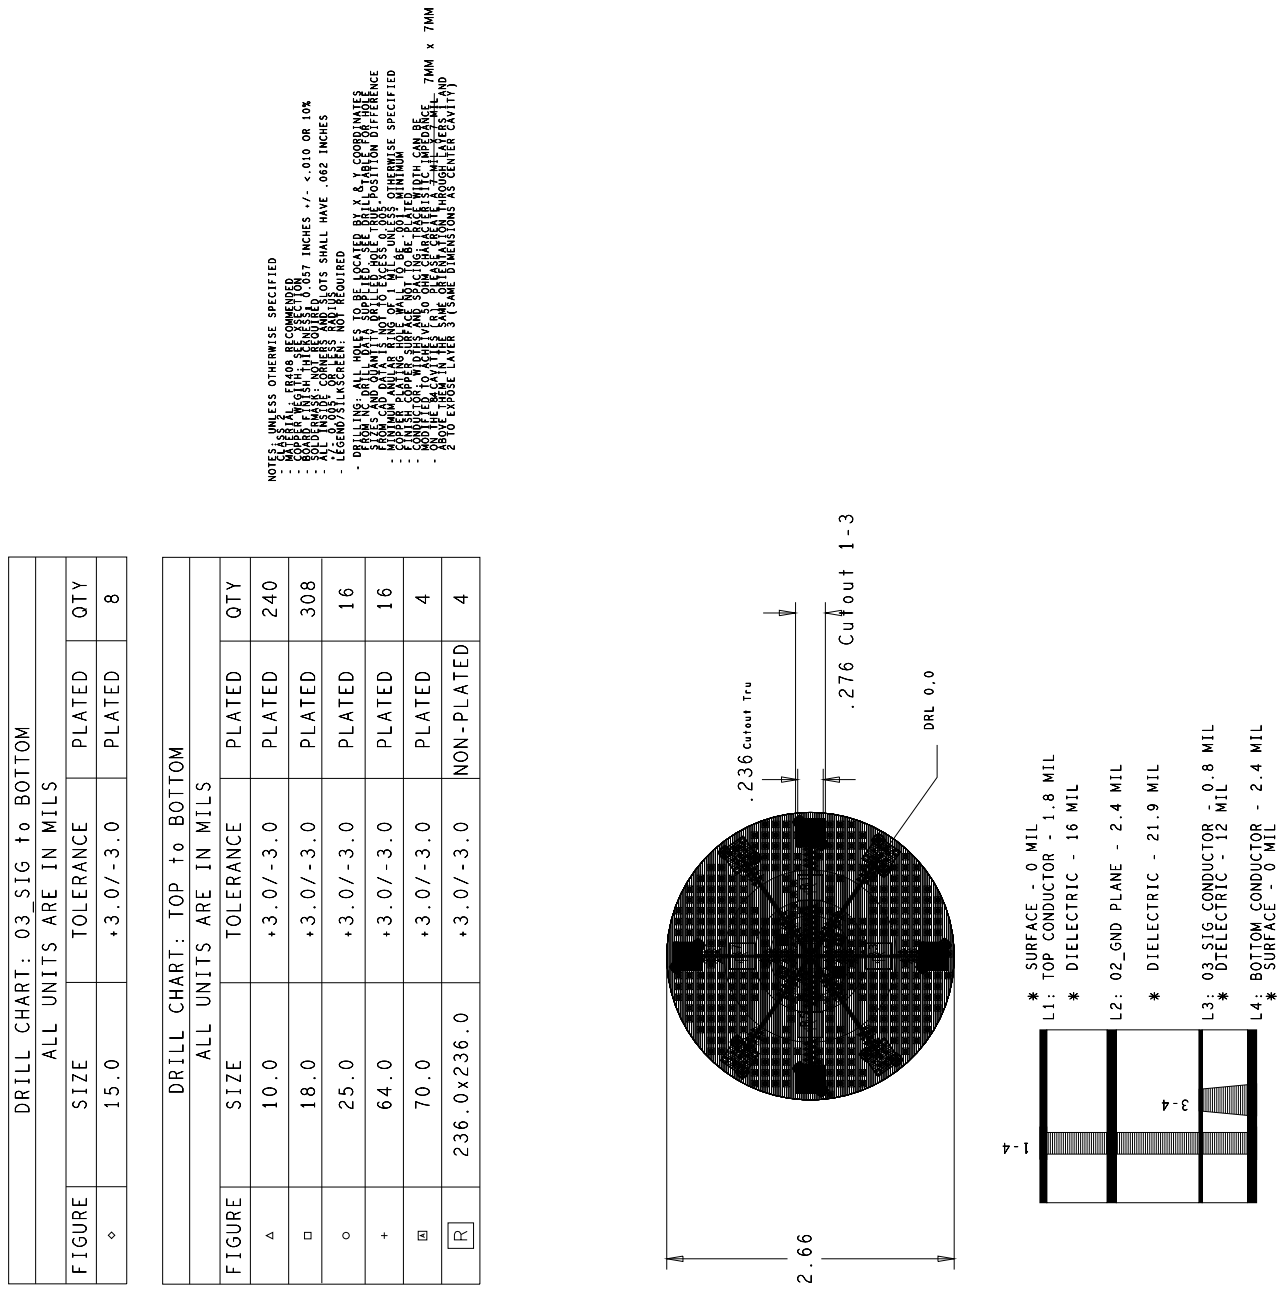
[picture p19: page 1]
