najjarapu/PCB_Waveguides_for_Houck_Lab_of_Quantum_Computing/Cadence Allegro Files/allegro_project/worklib/test070615/physical/Art/98_board_art/GERBER/98FabArt.pdf

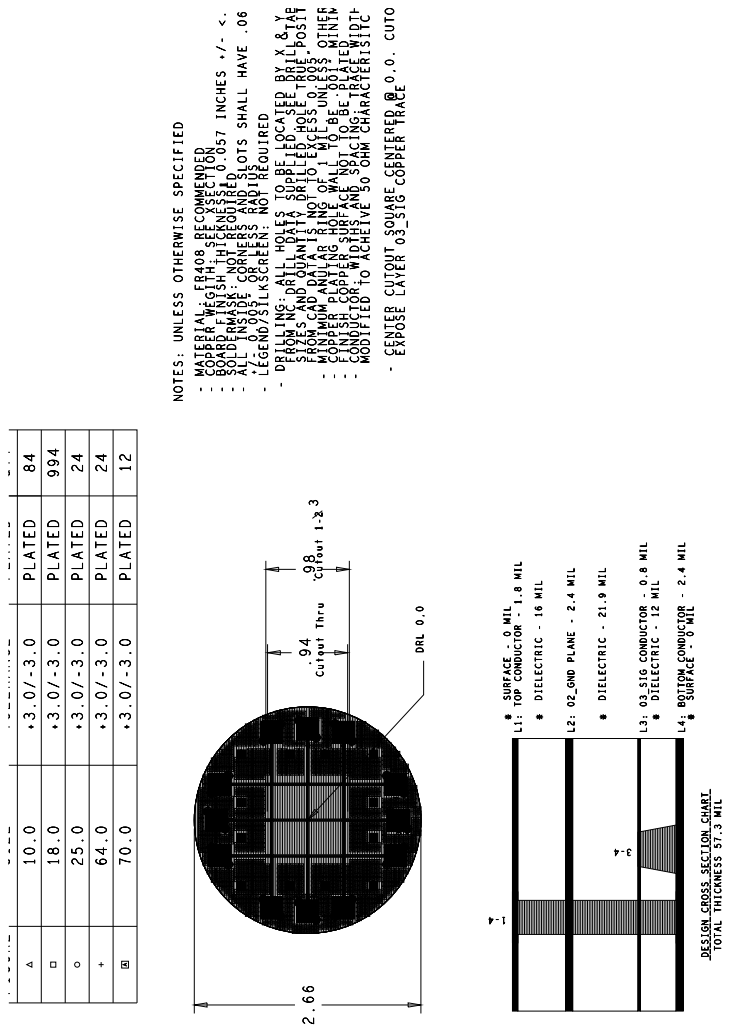
[picture p20: page 1]
