najjarapu/PCB_Waveguides_for_Houck_Lab_of_Quantum_Computing/Cadence Allegro Files/allegro_project/worklib/test070615/physical/oldart/filterboard_art_old/FilterboardFabArt.pdf

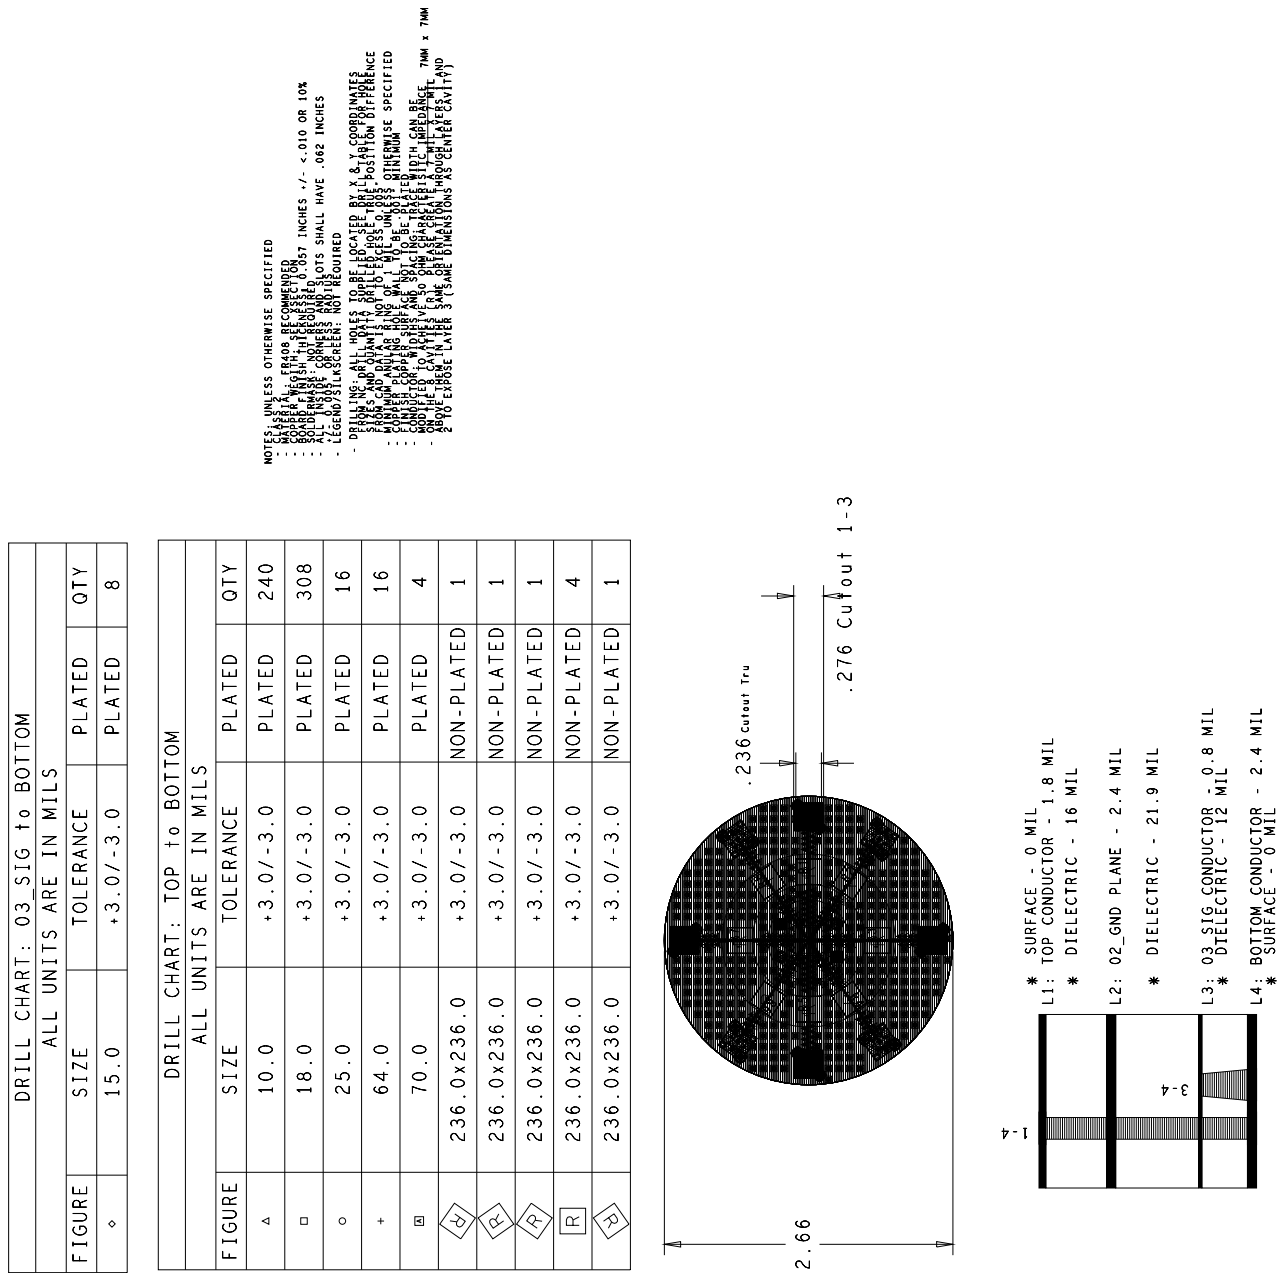
[picture p21: page 1]
