najjarapu/PCB_Waveguides_for_Houck_Lab_of_Quantum_Computing/(list of files, drawings)

Other design files:
Cadence Allegro Files/allegro_project/worklib/test070615/pspice/74ac.olb
Cadence Allegro Files/allegro_project/worklib/test070615/pspice/74act.olb
Cadence Allegro Files/allegro_project/worklib/test070615/pspice/74als.olb
Cadence Allegro Files/allegro_project/worklib/test070615/pspice/74as.olb
Cadence Allegro Files/allegro_project/worklib/test070615/pspice/7400.olb
