najjarapu/PCB_Waveguides_for_Houck_Lab_of_Quantum_Computing/Cadence Allegro Files/allegro_project/worklib/test070615/physical/nc_param.txt

INTEGER-PLACES         2
DECIMAL-PLACES         5
X-OFFSET               0.000000
Y-OFFSET               0.000000
FEEDRATE               1
COORDINATES            ABSOLUTE
OUTPUT-UNITS           ENGLISH
TOOL-ORDER             INCREASING
REPEAT-CODES           YES
SUPPRESS-LEAD-ZEROES   NO
SUPPRESS-TRAIL-ZEROES  NO
SUPPRESS-EQUAL         NO
TOOL-SELECT            YES
OPTIMIZE_DRILLING      YES
ENHANCED_EXCELLON      YES
TAPE-FILE              /n/homeserver2/user2a/ajjarapu/allegro_project/worklib/test070615/physical/FILTERBOARD_PARTIAL_ART/FILTERBOARDPARTIALDRL.drl
ROUTE-FILE             /n/homeserver2/user2a/ajjarapu/allegro_project/worklib/test070615/physical/FILTERBOARD_PARTIAL_ART/FILTERBOARDPARTIALROUTE.rou
HEADER                 none
LEADER                 12
CODE                   ASCII
SEPARATE               YES
SEPARATE-ROUTING       YES
DRILLING               LAYER-PAIR
BACKDRILL              NO
CAVITY                 NO
