najjarapu/PCB_Waveguides_for_Houck_Lab_of_Quantum_Computing/Cadence Allegro Files/allegro_project/worklib/test070615/physical/xsectionChartParams.txt

LAYER_NAME YES
LAYER_THICKNESS YES
MATERIAL_NAME NO
EMB_STATUS NO
ATTACH_METHOD NO
LAYER_TYPE YES
DRILL_SPAN YES
STACKED_VIAS YES
EMD_COMP_LEGEND  NO
DRILL_LABEL  YES
X_SCALE_FACTOR  2.000
DIELECTRIC_SCALE_FACTOR  1.000
TEXT_BLOCK  4
MAX_CHART_HEIGHT 2000 MIL
